TheDIYGuy999/MPPT_Buck_Converter_Synchronous/Schematic.pdf

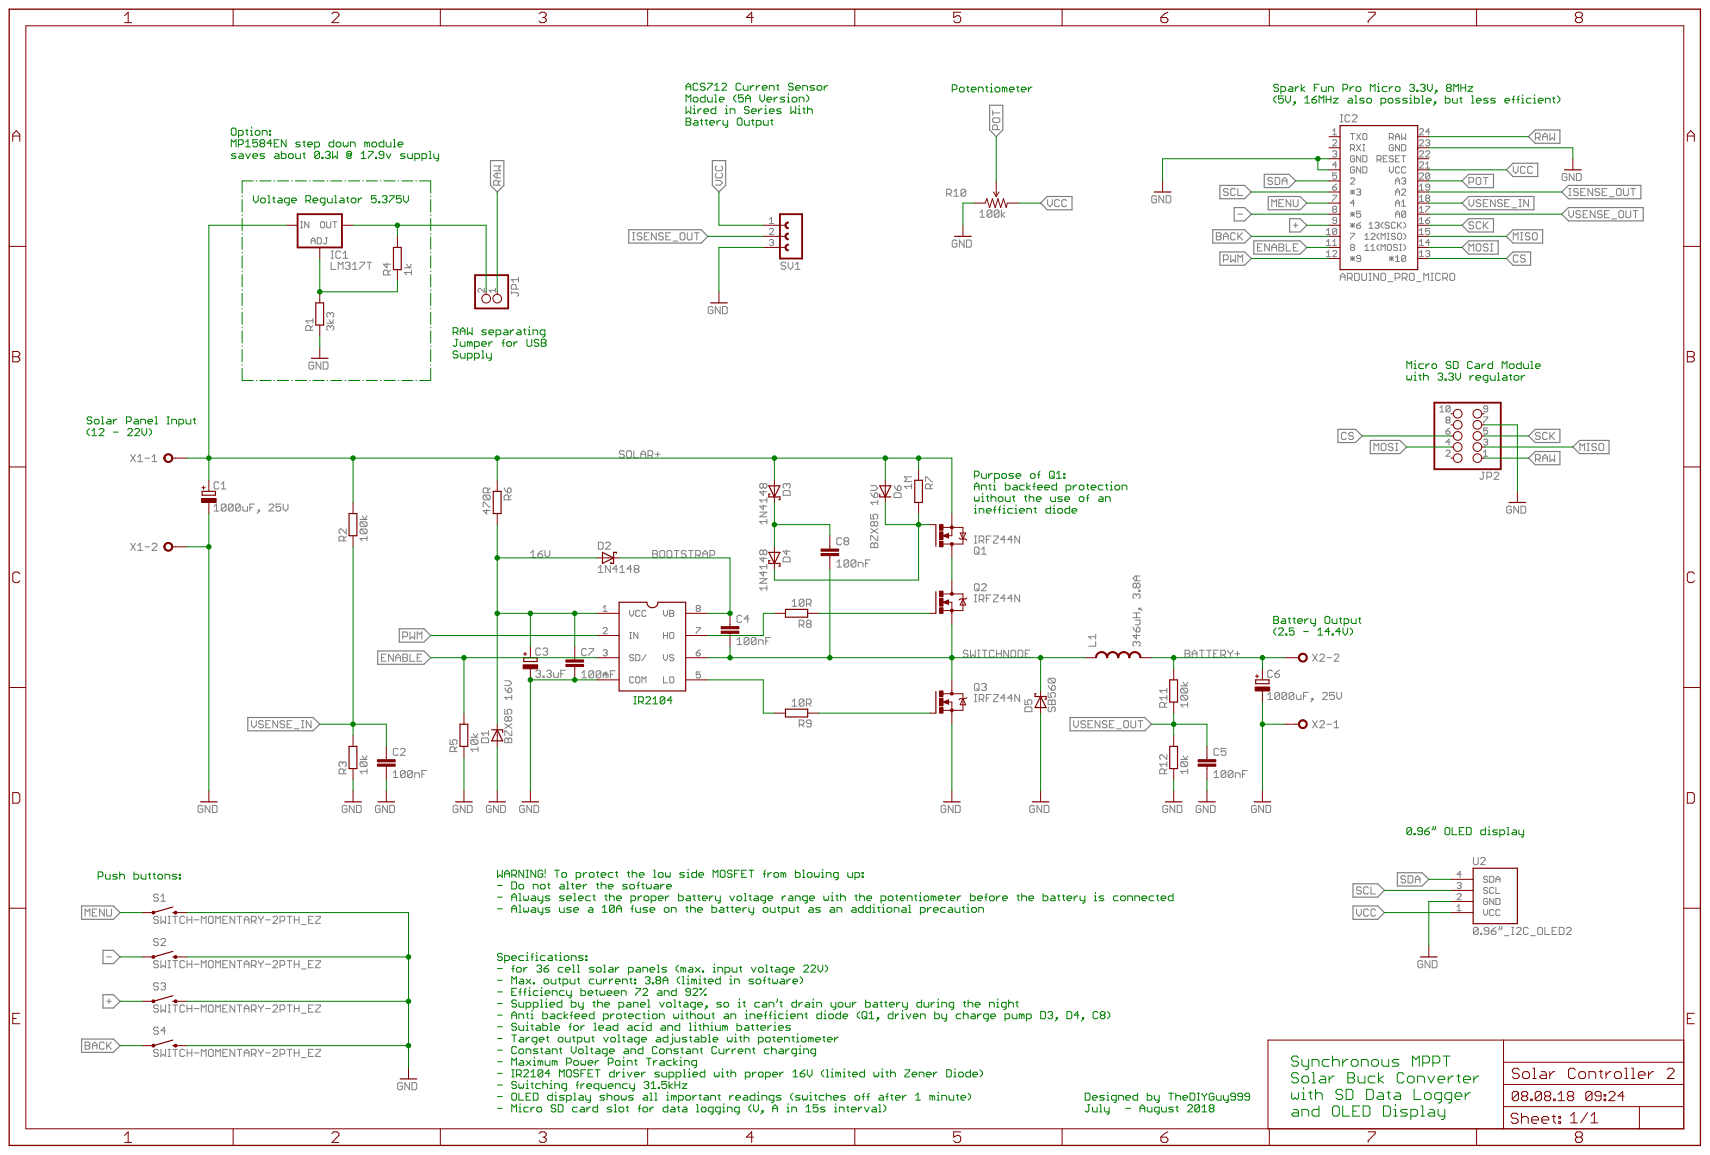
[picture p5: page 1]
