TheDIYGuy999/MPPT_Buck_Converter_Synchronous/Measurements.xlsx

PWM | Input V | Output V no load | Output V @ 0.5A | Output V @ 1A
12 | 19.18 | 0.8 | 0.78 | 0.84
20 | 19.28 | 1.36
25 | 19.28 | 1.78
30 | 19.28 | 2.15 | 2.1 | 2.15
35 | 19.15 | 2.51
40 | 19.18 | 2.91
45 | 19.1 | 3.33
50 | 19.18 | 3.7 | 3.6 | 3.76
55 | 19.05 | 4.05
60 | 19.15 | 4.42
65 | 19.13 | 4.89
70 | 19.15 | 5.2 | 5.02 | 5.07
75 | 19.13 | 5.57
80 | 19.1 | 5.9
85 | 19.05 | 6.35
90 | 19.13 | 6.79 | 6.43 | 6.51
95 | 19.05 | 7.11
100 | 19.13 | 7.47
105 | 19.13 | 7.9
110 | 19.05 | 8.22 | 8.05 | 8.26
115 | 19.1 | 8.6
120 | 19.05 | 9.04
125 | 19.1 | 9.4
130 | 19.13 | 9.77 | 9.56 | 9.72
135 | 19.13 | 10.09
140 | 19.05 | 10.66
145 | 19 | 10.85
150 | 19 | 11.35 | 11.13 | 11.08
155 | 19.1 | 11.71
160 | 19.13 | 12.09
165 | 19 | 12.44
170 | 19.05 | 12.87 | 12.65 | 12.7
175 | 19.13 | 13.22
180 | 19.05 | 13.64
185 | 19.15 | 14.01
190 | 19.15 | 14.4 | 14.19 | 14.36
