TheDIYGuy999/MPPT_Buck_Converter_Synchronous/(commit log)

2018-07-26 V1.0: initial commit
    [Measurements.xlsx]
2022-08-02 v1.2: optimized for 4.2V direct charging
